kallikak/CLFM/README.md

# CLFM
Cherchez la FM - 4 operator Eurorack voice

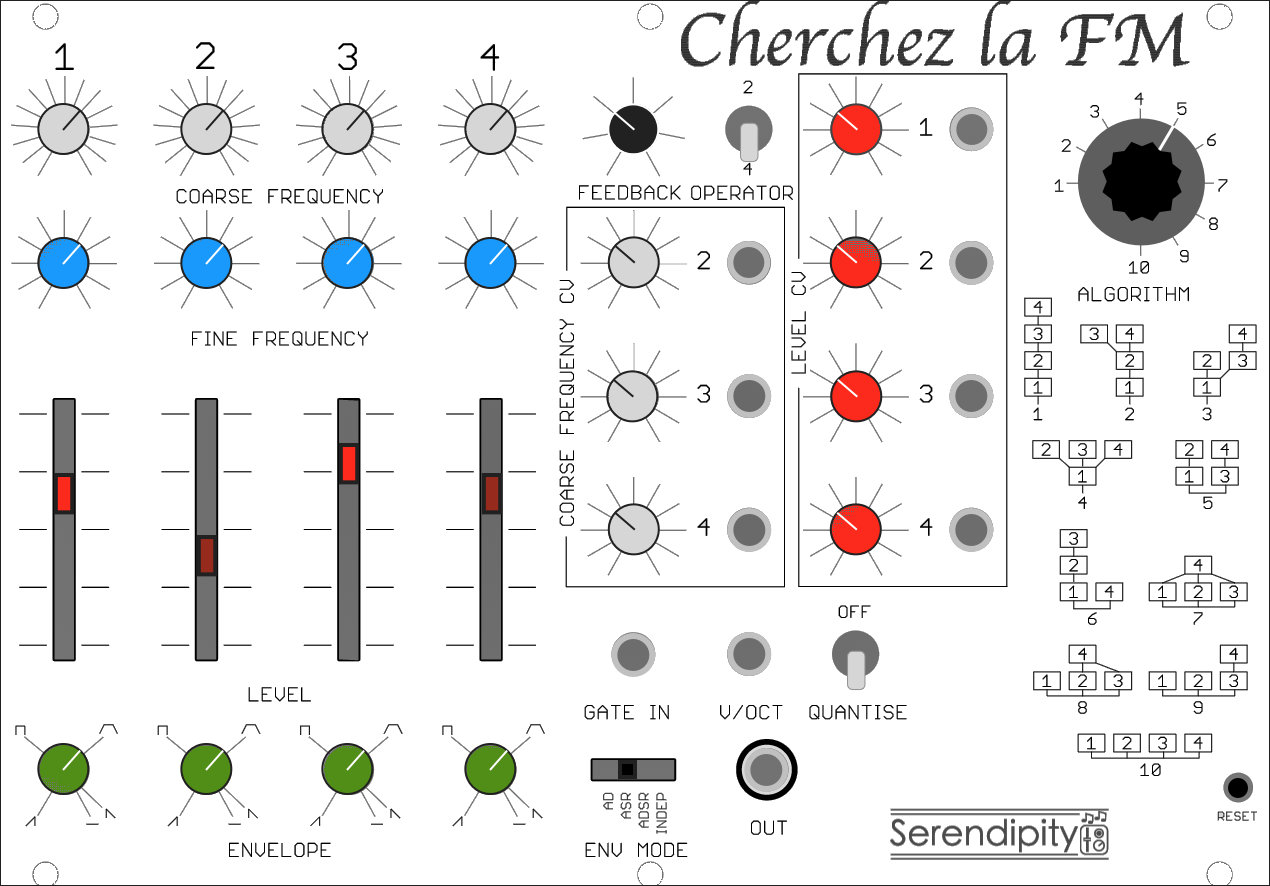
[picture p1: CLFM.png]
Panel


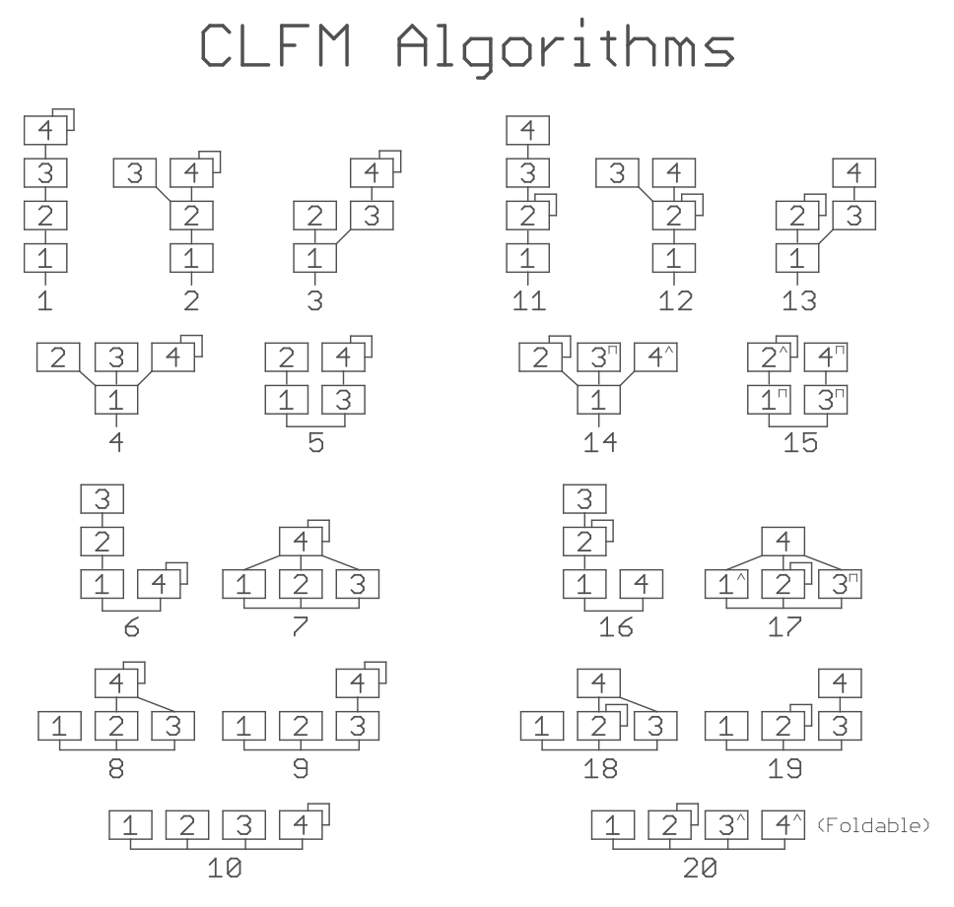
[picture p2: Algorithms.png]
Algorithms


See the build guide http://thewessens.net/CLFM/CLFMbuild.html for more information.
