kallikak/CLFM/hardware/PCM5102A.png

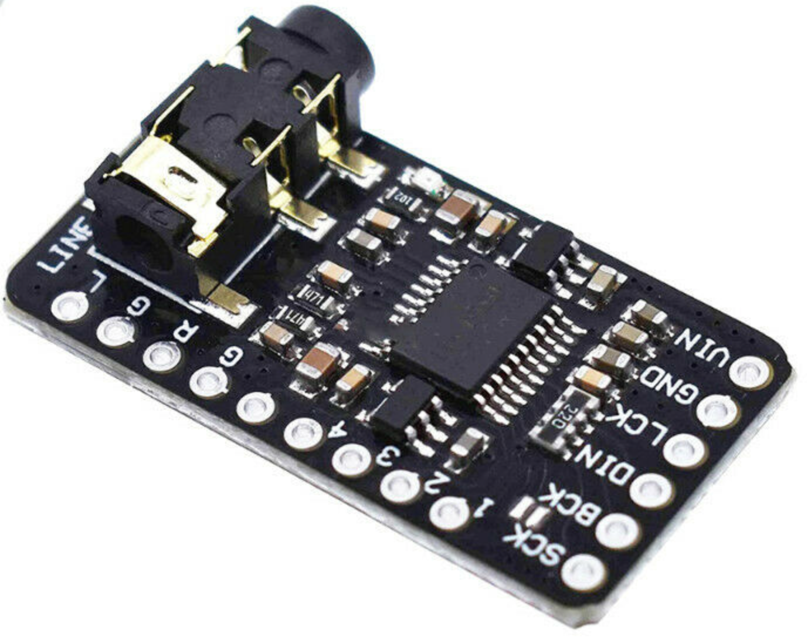
hardware/PCM5102A.png
