kallikak/CLFM/hardware/FM-1.2.1.brd

## EAGLE design hardware/FM-1.2.1.brd (2022-07-24)

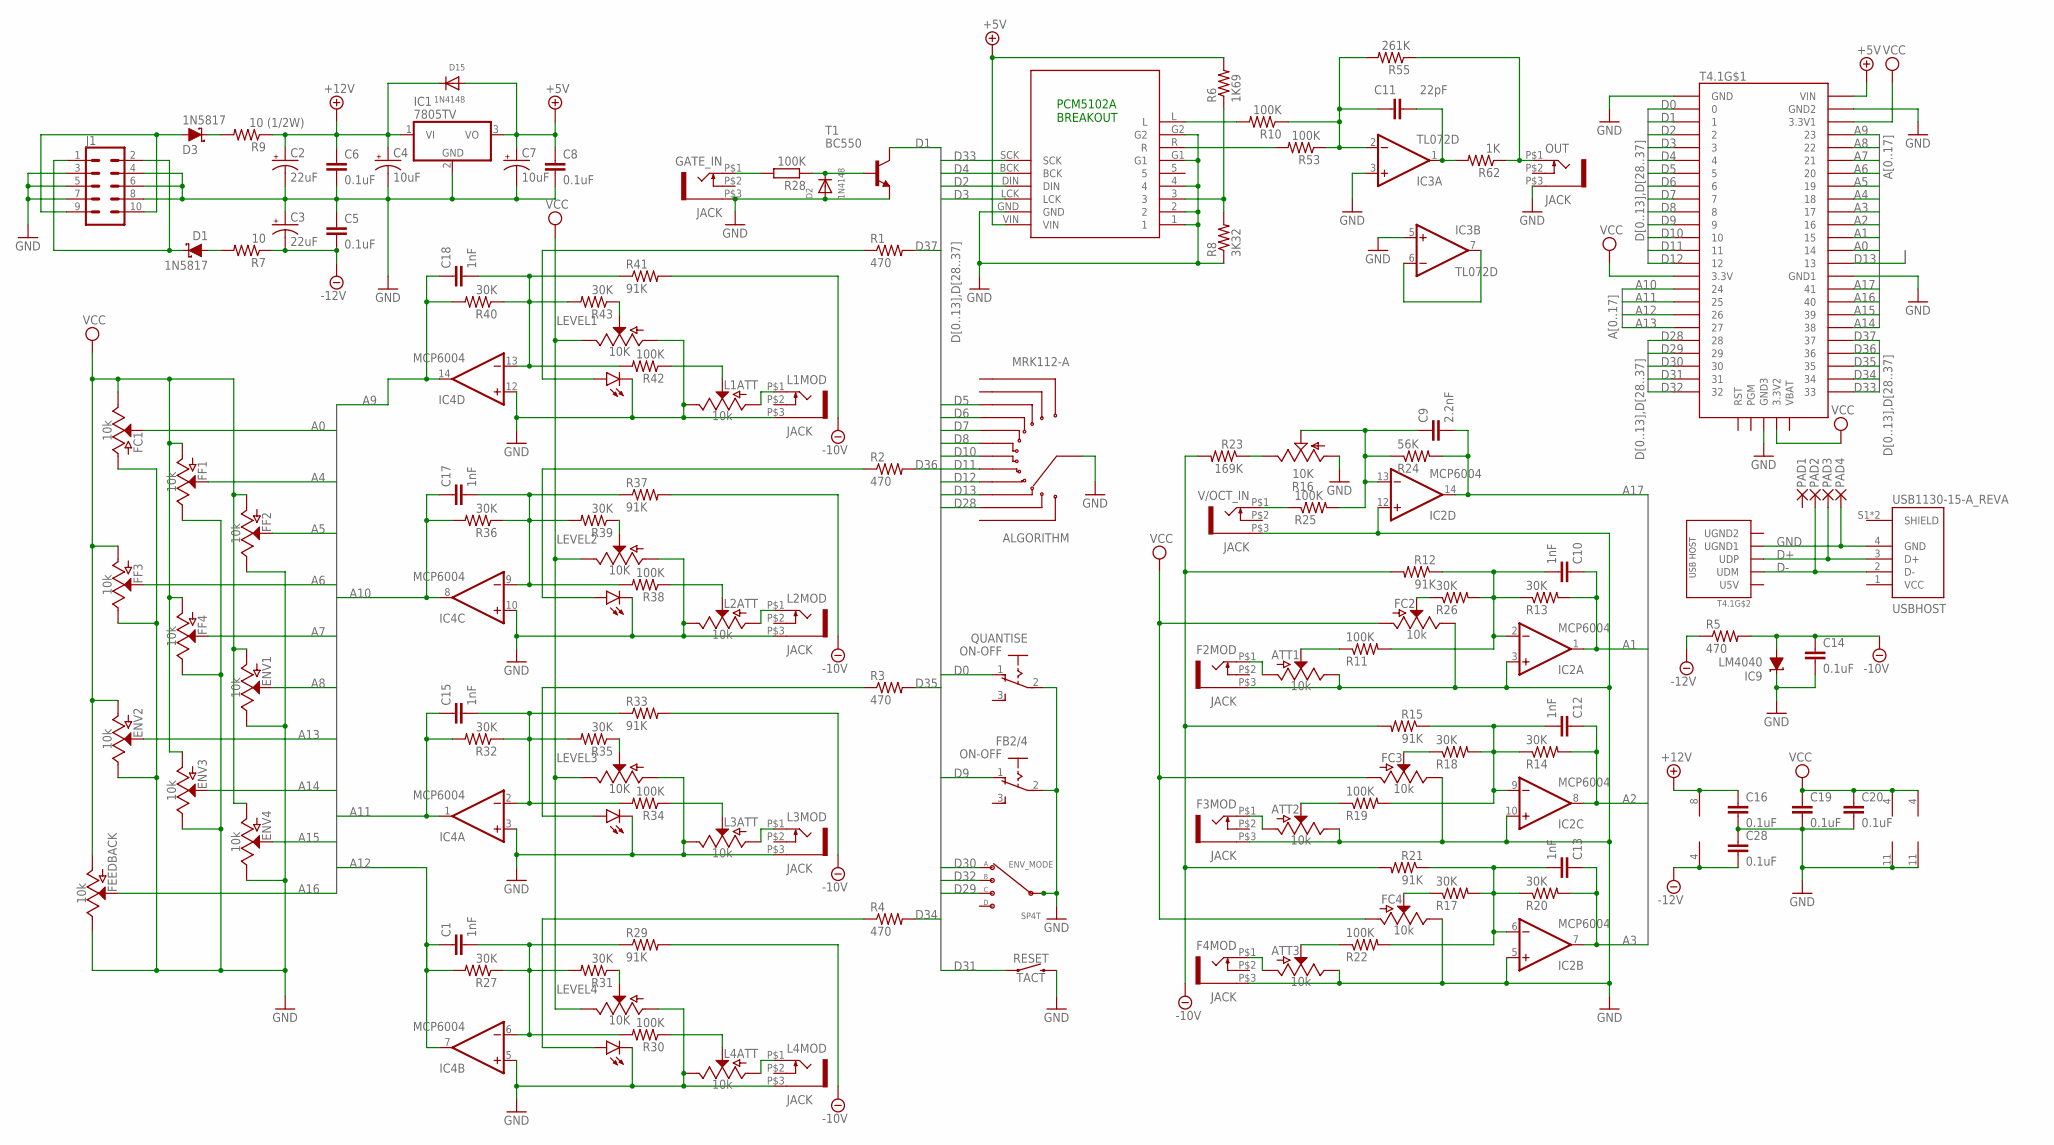
[picture p5: schematic FM-1.2.1.sch]

Parts:
ALGORITHM: MRK112-A; SW_MRK112-A
ATT1, ATT2, ATT3: 10k; POT-PTH-ALPS
C1, C10, C12, C13, C15, C17, C18: 1nF; C0603K
C2, C3: 22uF; CPOL-RADIAL-2.5MM-5MM
C4, C7: 10uF; CPOL-RADIAL-2.5MM-5MM
C5, C6, C8, C14, C16, C19, C20, C28: 0.1uF; C0603K
C9: 2.2nF; C0603K
C11: 22pF; C0603K
D1, D3: 1N5817; SOD-323
D2, D15: 1N4148; SOD-123
ENV1, ENV2, ENV3, ENV4: 10k; POT-PTH-ALPS
ENV_MODE: SP4T
F2MOD, F3MOD, F4MOD: JACK; WQP-PJ301M-12_JACK
FB2/4: ON-OFF; 255SB
FC1, FC2, FC3, FC4: 10k; POT-PTH-ALPS
FEEDBACK: 10k; POT-PTH-ALPS
FF1, FF2, FF3, FF4: 10k; POT-PTH-ALPS
GATE_IN: JACK; WQP-PJ301M-12_JACK
IC1: 7805TV; TO220V
IC2, IC4: MCP6004; SO14
IC3: TL072D; SO08
IC9: LM4040; LP_O-PBCY-W3
J1: CONN_05X2SHD; 2X5-SHROUDED
L1ATT, L2ATT, L3ATT, L4ATT: 10k; POT-PTH-ALPS
L1MOD, L2MOD, L3MOD, L4MOD: JACK; WQP-PJ301M-12_JACK
LEVEL1, LEVEL2, LEVEL3, LEVEL4: 10K; SLIDER-MEDIUM-LED
OUT: JACK; WQP-PJ301M-12_JACK
PAD1, PAD2, PAD3, PAD4: 1,6/0,9
QUANTISE: ON-OFF; 255SB
R1, R2, R3, R4, R5: 470; R0603
R6: 1K69; R0603
R7: 10; R0603
R8: 3K32; R0603
R9: 10 (1/2W); 0207/10
R10, R11, R19, R22, R25, R28, R30, R34, R38, R42, R53: 100K; R0603
R12, R15, R21, R29, R33, R37, R41: 91K; R0603
R13, R14, R17, R18, R20, R26, R27, R31, R32, R35, R36, R39, R40, R43: 30K; R0603
R16: 10K; B25P
R23: 169K; R0603
R24: 56K; R0603
R55: 261K; R0603
R62: 1K; R0603
RESET: TACT; TACTILE_SWITCH_PTH_6.0MM
T1: BC550; TO92
T4.1: TEENSY4.1
U$2: PCM5102A BREAKOUT; I2S_PCM_5100_SOUNDCARD
USBHOST: USB1130-15-A_REVA; GCT_USB1130-15-A_REVA
V/OCT_IN: JACK; WQP-PJ301M-12_JACK

Connections:
+5V: C7.1 (+), C8.1, D15.A, IC1.3 (VO), R6.2, T4.1.VIN, U$2.VIN
+12V: C2.1 (+), C4.1 (+), C6.1, C16.1, D15.C, IC1.1 (VI), IC3.8 (V+), R9.1
-10V: C14.1, IC9.3 (A), R5.2, R12.2, R15.2, R21.2, R23.2, R29.2, R33.2, R37.2, R41.2
-12V: C3.2 (-), C5.2, C28.2, IC3.4 (V-), R5.1, R7.1
A0: FC1.P$2 (S), T4.1.14/A0 (14)
A1: C10.1, IC2.1 (OUT), R13.2, T4.1.15/A1 (15)
A2: C12.1, IC2.8 (OUT), R14.2, T4.1.16/A2 (16)
A3: C13.1, IC2.7 (OUT), R20.2, T4.1.17/A3 (17)
A4: FF1.P$2 (S), T4.1.18/A4/SDA (18)
A5: FF2.P$2 (S), T4.1.19/A5/SCL (19)
A6: FF3.P$2 (S), T4.1.20/A6 (20)
A7: FF4.P$2 (S), T4.1.21/A7 (21)
A8: ENV1.P$2 (S), T4.1.22/A8 (22)
A9: C18.1, IC4.14 (OUT), R40.2, T4.1.23/A9 (23)
A10: C17.1, IC4.8 (OUT), R36.2, T4.1.24
A11: C15.1, IC4.1 (OUT), R32.2, T4.1.25
A12: C1.1, IC4.7 (OUT), R27.2, T4.1.26
A13: ENV2.P$2 (S), T4.1.27
A14: ENV3.P$2 (S), T4.1.38
A15: ENV4.P$2 (S), T4.1.39
A16: FEEDBACK.P$2 (S), T4.1.40
A17: C9.2, IC2.14 (OUT), R24.2, T4.1.41
D0: QUANTISE.1 (O), T4.1.0/RX (0)
D1: T1.3 (C), T4.1.1/TX (1)
D2: T4.1.2, U$2.DIN
D3: T4.1.3, U$2.LCK
D4: T4.1.4, U$2.BCK
D5: ALGORITHM.10, T4.1.5
D6: ALGORITHM.9, T4.1.6
D7: ALGORITHM.8, T4.1.7
D8: ALGORITHM.7, T4.1.8
D9: FB2/4.1 (O), T4.1.9
D10: ALGORITHM.6, T4.1.10/CS (10)
D11: ALGORITHM.5, T4.1.11/MOSI (11)
D12: ALGORITHM.4, T4.1.12/MISO (12)
D13: ALGORITHM.3, T4.1.13/SCK (13)
D28: ALGORITHM.2, T4.1.28
D29: ENV_MODE.4 (C), T4.1.29
D30: ENV_MODE.2 (A), T4.1.30
D31: RESET.1, T4.1.31/A12 (31)
D32: ENV_MODE.3 (B), T4.1.32
D33: T4.1.33, U$2.SCK
D34: R4.2, T4.1.34
D35: R3.2, T4.1.35
D36: R2.2, T4.1.36
D37: R1.2, T4.1.37
D+: PAD3.1, T4.1.UD+ (UDP), USBHOST.3 (D+)
D-: PAD2.1, T4.1.UD- (UDM), USBHOST.2 (D-)
GND: ALGORITHM.A, ATT1.P$1 (E), ATT2.P$1 (E), ATT3.P$1 (E), C2.2 (-), C3.1 (+), C4.2 (-), C5.1, C6.2, C7.2 (-), C8.2, C14.2, C16.2, C19.2, C20.2, C28.1, D2.A, ENV1.P$1 (E), ENV2.P$1 (E), ENV3.P$1 (E), ENV4.P$1 (E), ENV_MODE.1 (INPUT), ENV_MODE.6, F2MOD.P$3 (1), F3MOD.P$3 (1), F4MOD.P$3 (1), FB2/4.2, FC1.P$3 (A), FC2.P$1 (E), FC3.P$1 (E), FC4.P$1 (E), FEEDBACK.P$1 (E), FF1.P$1 (E), FF2.P$1 (E), FF3.P$1 (E), FF4.P$1 (E), GATE_IN.P$3 (1), IC1.2 (GND), IC2.3 (+IN), IC2.5 (+IN), IC2.10 (+IN), IC2.11 (V-), IC2.12 (+IN), IC3.3 (+IN), IC3.5 (+IN), IC4.3 (+IN), IC4.5 (+IN), IC4.10 (+IN), IC4.11 (V-), IC4.12 (+IN), IC9.2 (C), J1.3, J1.4, J1.5, J1.6, J1.7, J1.8, L1ATT.P$1 (E), L1MOD.P$3 (1), L2ATT.P$1 (E), L2MOD.P$3 (1), L3ATT.P$1 (E), L3MOD.P$3 (1), L4ATT.P$1 (E), L4MOD.P$3 (1), LEVEL1.P$1 (1), LEVEL1.P$E (E), LEVEL2.P$1 (1), LEVEL2.P$E (E), LEVEL3.P$1 (1), LEVEL3.P$E (E), LEVEL4.P$1 (1), LEVEL4.P$E (E), OUT.P$3 (1), PAD4.1, QUANTISE.2, R8.1, R16.A, RESET.3 (2), T1.1 (E), T4.1.AGND (GND2), T4.1.GND, T4.1.GND1, T4.1.GND2 (GND3), T4.1.GND-U1 (UGND1), U$2.1, U$2.2, U$2.4, U$2.G1, U$2.G2, U$2.GND, USBHOST.4 (GND), V/OCT_IN.P$3 (1)
unnamed: C11.2, IC3.1 (OUT), R62.2
unnamed: LEVEL3.P$B (B), R3.1
unnamed: C15.2, IC4.2 (-IN), R32.1, R33.1, R34.2, R35.2
unnamed: D1.C, J1.1, J1.2
unnamed: R25.1, V/OCT_IN.P$1 (2)
unnamed: D3.A, J1.9, J1.10
unnamed: D3.C, R9.2
unnamed: LEVEL3.P$2 (2), R35.1
unnamed: D1.A, R7.2
unnamed: LEVEL4.P$B (B), R4.1
unnamed: R10.2, U$2.L
unnamed: R6.1, R8.2, U$2.3
unnamed: R53.2, U$2.R
unnamed: ATT2.P$3 (A), F3MOD.P$1 (2)
unnamed: FC2.P$2 (S), R26.1
unnamed: C10.2, IC2.2 (-IN), R11.2, R12.1, R13.1, R26.2
unnamed: C12.2, IC2.9 (-IN), R14.1, R15.1, R18.2, R19.2
unnamed: ATT1.P$2 (S), R11.1
unnamed: C13.2, IC2.6 (-IN), R17.2, R20.1, R21.1, R22.2
unnamed: ATT2.P$2 (S), R19.1
unnamed: C9.1, IC2.13 (-IN), R16.S, R24.1, R25.2
unnamed: FC4.P$2 (S), R17.1
unnamed: ATT3.P$3 (A), F4MOD.P$1 (2)
unnamed: FC3.P$2 (S), R18.1
unnamed: R16.E, R23.1
unnamed: IC3.6 (-IN), IC3.7 (OUT)
unnamed: ATT3.P$2 (S), R22.1
unnamed: ATT1.P$3 (A), F2MOD.P$1 (2)
unnamed: GATE_IN.P$1 (2), R28.2
unnamed: D2.C, R28.1, T1.2 (B)
unnamed: C1.2, IC4.6 (-IN), R27.1, R29.1, R30.2, R31.2
unnamed: LEVEL4.P$2 (2), R31.1
unnamed: L4ATT.P$3 (A), L4MOD.P$1 (2)
unnamed: L4ATT.P$2 (S), R30.1
unnamed: L3ATT.P$3 (A), L3MOD.P$1 (2)
unnamed: L3ATT.P$2 (S), R34.1
unnamed: LEVEL2.P$B (B), R2.1
unnamed: C17.2, IC4.9 (-IN), R36.1, R37.1, R38.2, R39.2
unnamed: LEVEL2.P$2 (2), R39.1
unnamed: L2ATT.P$3 (A), L2MOD.P$1 (2)
unnamed: L2ATT.P$2 (S), R38.1
unnamed: LEVEL1.P$B (B), R1.1
unnamed: C18.2, IC4.13 (-IN), R40.1, R41.1, R42.2, R43.2
unnamed: LEVEL1.P$2 (2), R43.1
unnamed: L1ATT.P$3 (A), L1MOD.P$1 (2)
unnamed: L1ATT.P$2 (S), R42.1
unnamed: C11.1, IC3.2 (-IN), R10.1, R53.1, R55.2
unnamed: OUT.P$1 (2), R55.1, R62.1
VCC: C19.1, C20.1, ENV1.P$3 (A), ENV2.P$3 (A), ENV3.P$3 (A), ENV4.P$3 (A), FC1.P$1 (E), FC2.P$3 (A), FC3.P$3 (A), FC4.P$3 (A), FEEDBACK.P$3 (A), FF1.P$3 (A), FF2.P$3 (A), FF3.P$3 (A), FF4.P$3 (A), IC2.4 (V+), IC4.4 (V+), LEVEL1.P$3 (3), LEVEL2.P$3 (3), LEVEL3.P$3 (3), LEVEL4.P$3 (3), T4.1.3V3 (3.3V), T4.1.3V3_LO (3.3V1), T4.1.V33 (3.3V2), USBHOST.1 (VCC)

Notes on the sheet:
PCM5102A BREAKOUT

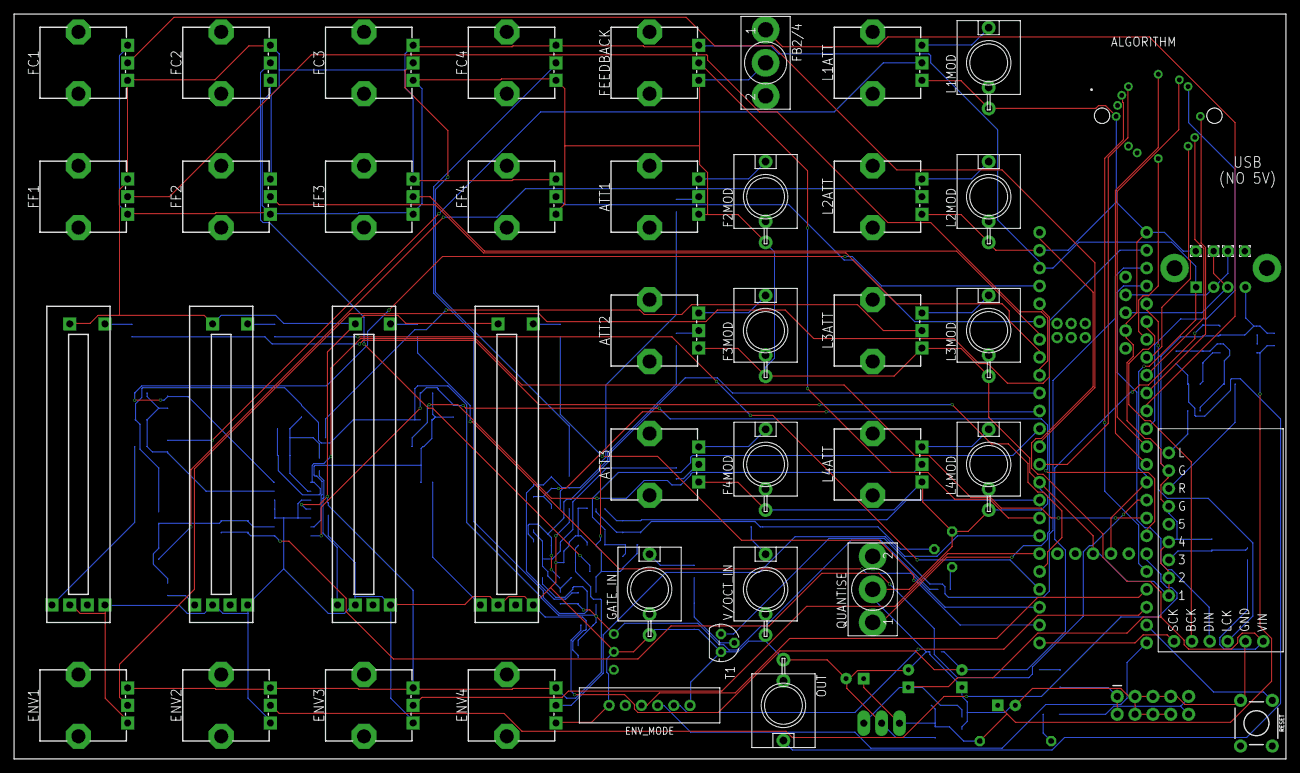
[picture p6: board FM-1.2.1.brd from above]

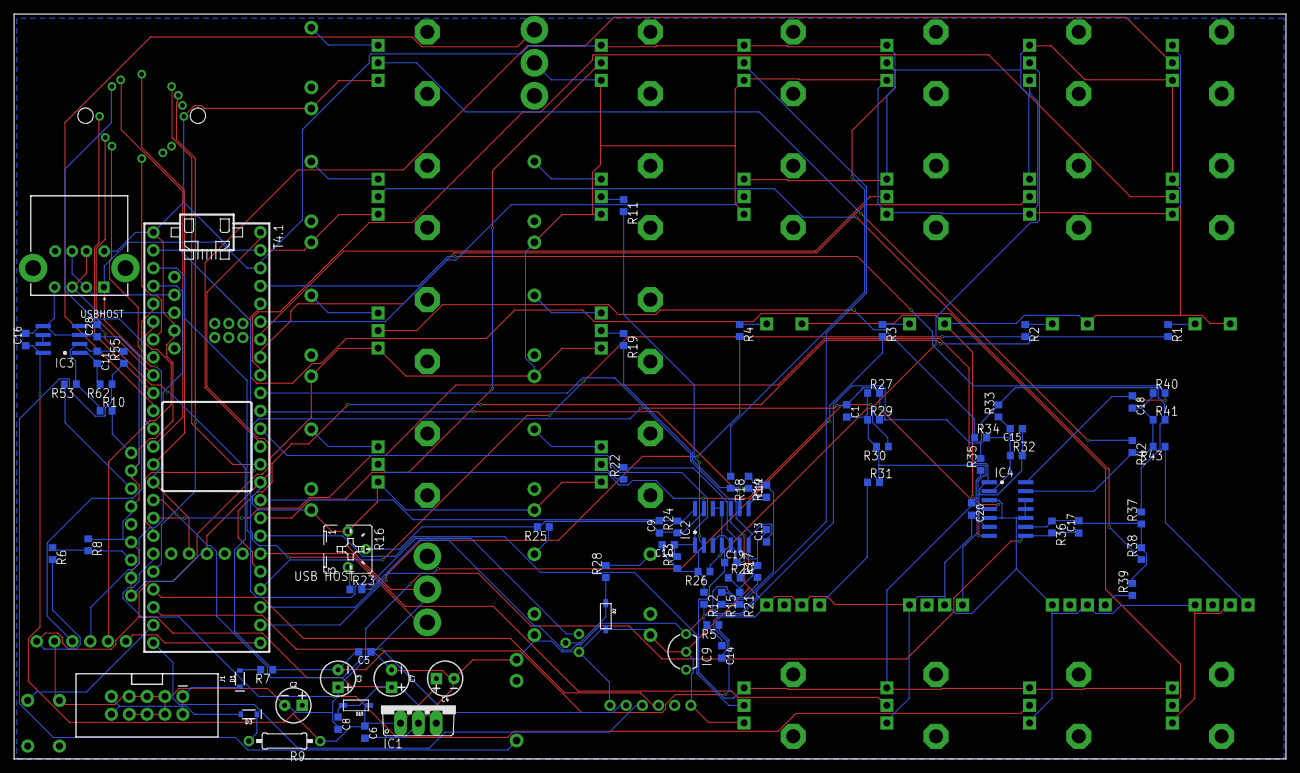
[picture p7: board FM-1.2.1.brd from below]

Board: 2 copper layers, 181.0 x 106.0 mm, 124 parts (79 on the bottom side), 98 nets.
