kallikak/CLFM/(commit log)

2022-06-26 Update CLFM-dexed.ino
    Fixed a startup glitch
    [CLFM-dexed.ino]
2022-06-27 Fix for FB-2 algorithm inbus
    [CLFM Parts.csv]
2022-06-29 mod wheel and aftertouch control of modulation
2022-06-29 Improved mod wheel and aftertouch scaling
2022-06-30 Update CLFM Parts.csv
    [CLFM Parts.csv]
2022-07-09 Removed special case folded wave code
2022-07-24 Removed prototype code
2022-07-24 Update to v1.2.1
    [FM-1.2-panel.brd, FM-1.2.1.brd, FM-1.2.1.sch]
2022-07-25 Added part to BOM
    [CLFM Parts.csv]
